sovetnikovmm/turn-signal-indicator/fabrication/turn-signal-indicator.step

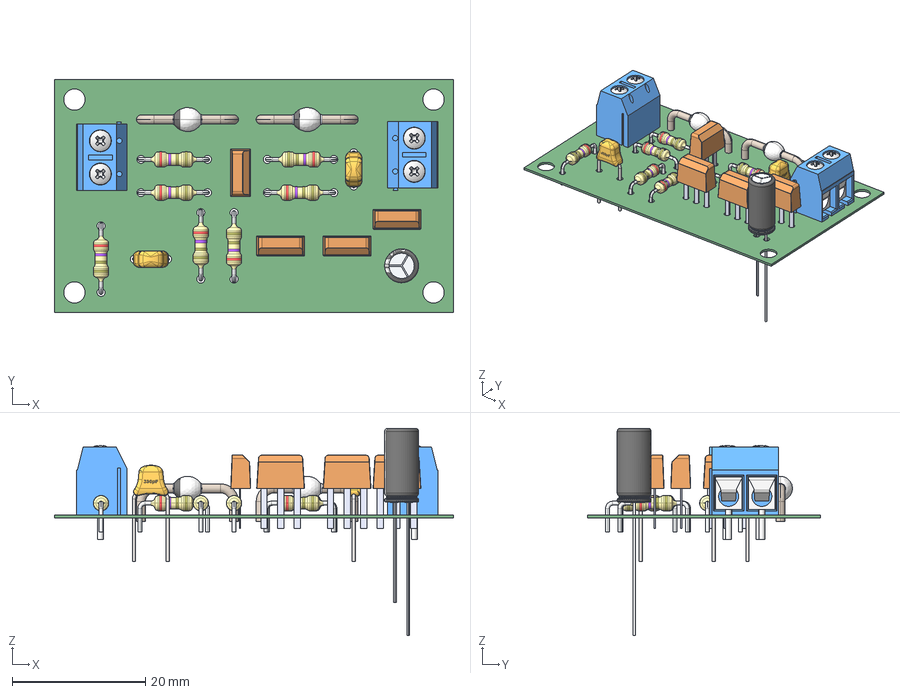
[picture p6: CAD file, 2026-11-12]
fabrication/turn-signal-indicator.step
60.0 x 35.0 x 31.2 mm
330pF MLCC Ceramic Capacitor x 4
Elco 10uF-35V (5 x 11 mm)
2.7R 0.4 x 7
User Library-KD29-C x 2
KT-13_1 x 4
case x 2
Terminal1 x 4
Screw1 x 4
