sovetnikovmm/turn-signal-indicator/docs/original-ru/turn-signal-indicator_E3_schematic.PDF

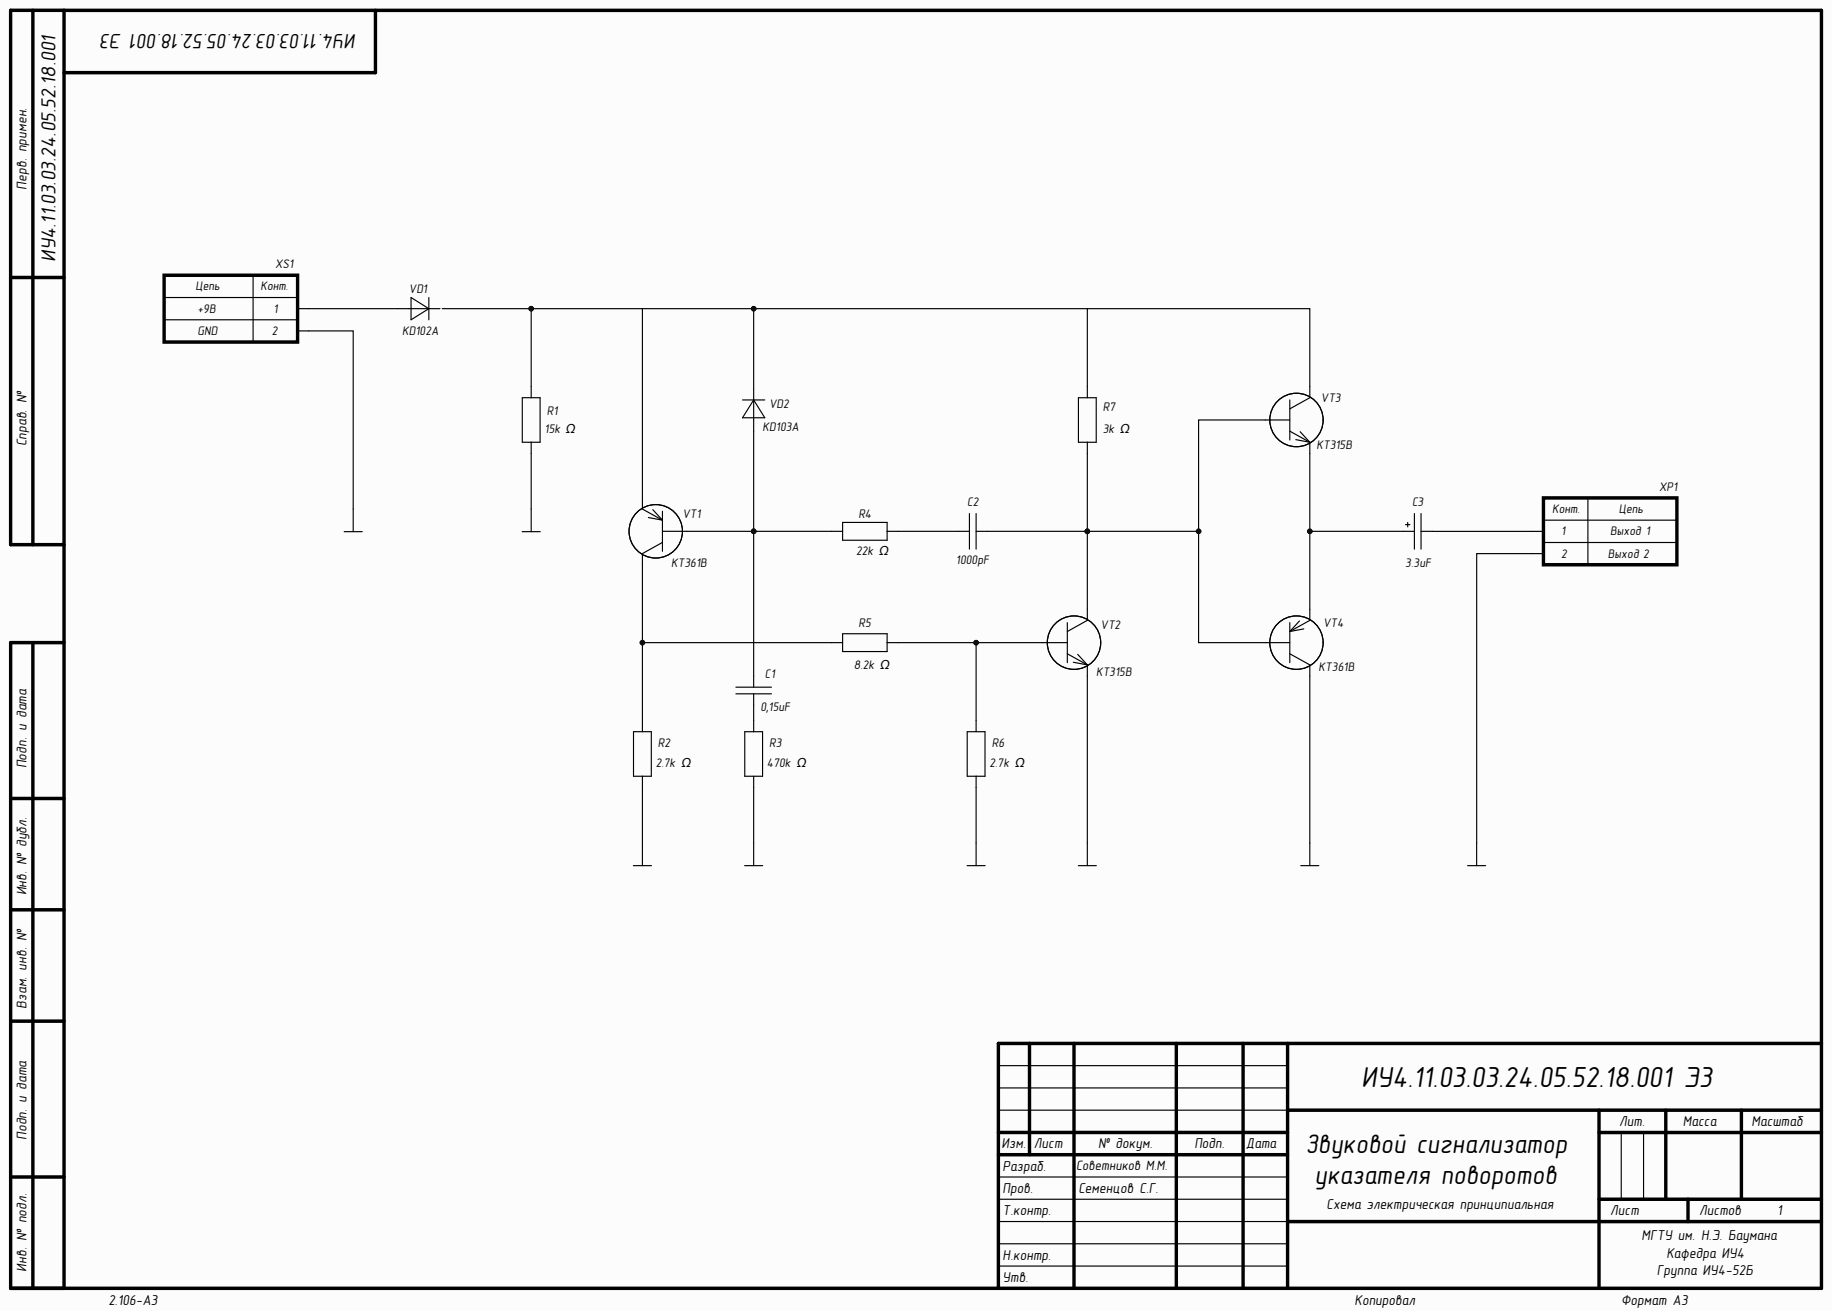
[picture p7: page 1]

Инв. № подл. Инв. № дубл. Подп. и дата Взам. инв. № Подп. и дата Перв. примен. Справ. №

Цеп ь | Конт .

GND

Конт . | Цеп ь

12 | Выход 1

Выход 2

Звуковой сигнализатор указателя поворотов Схема электрическая принципиальная | Лит . | Мас с а | Масштаб

Изм . | Лис т | № докум . | Подп . | Дата
Разраб . | | Советников М . М .
Пров . | | Семенцов С . Г .
Т .контр . | | | | | Лис т | Листов 1

МГТУ им. Н . Э. Баумана Кафедра ИУ 4 Группа ИУ4-52 Б

Н .контр .
Утв .
