sovetnikovmm/turn-signal-indicator/docs/original-ru/turn-signal-indicator_E1_block-diagram.PDF

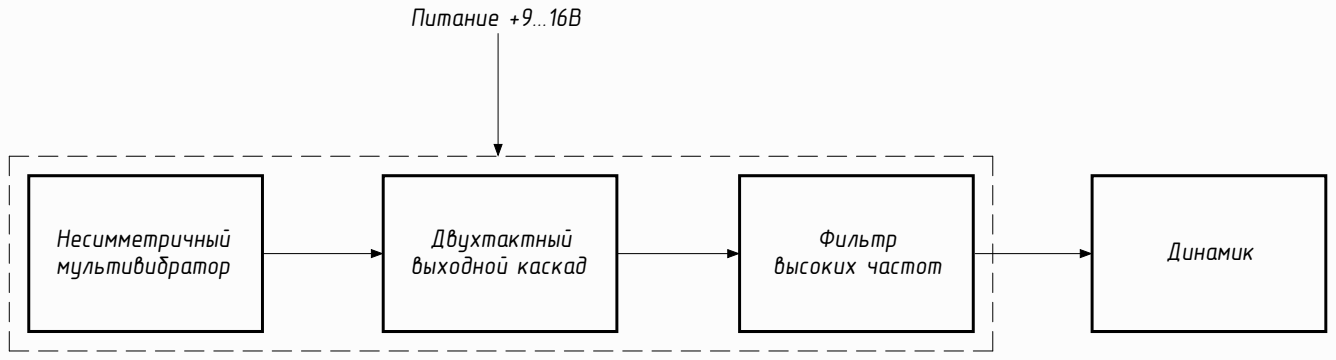
[picture p8: page 1]

Подп. и дата Перв. примен. Справ. №

Инв. № подл. Инв. № дубл. Подп. и дата Взам. инв. №

Звуковой сигнализатор указателя поворотов Схема электрическая структурная | Лит. | Масса | Масштаб

Изм. | Лист | № докум. | Подп. | Дата
Разраб. | | Советников М.М.
Пров. | | Семенцов С.Г.
Т.контр. | | | | | Лист | Листов 1

МГТУ им. Н.Э. Баумана Кафедра ИУ4 Группа ИУ4-52Б

Н.контр.
Утв.
