sovetnikovmm/turn-signal-indicator/docs/original-ru/turn-signal-indicator_PP_board-drawing.PDF

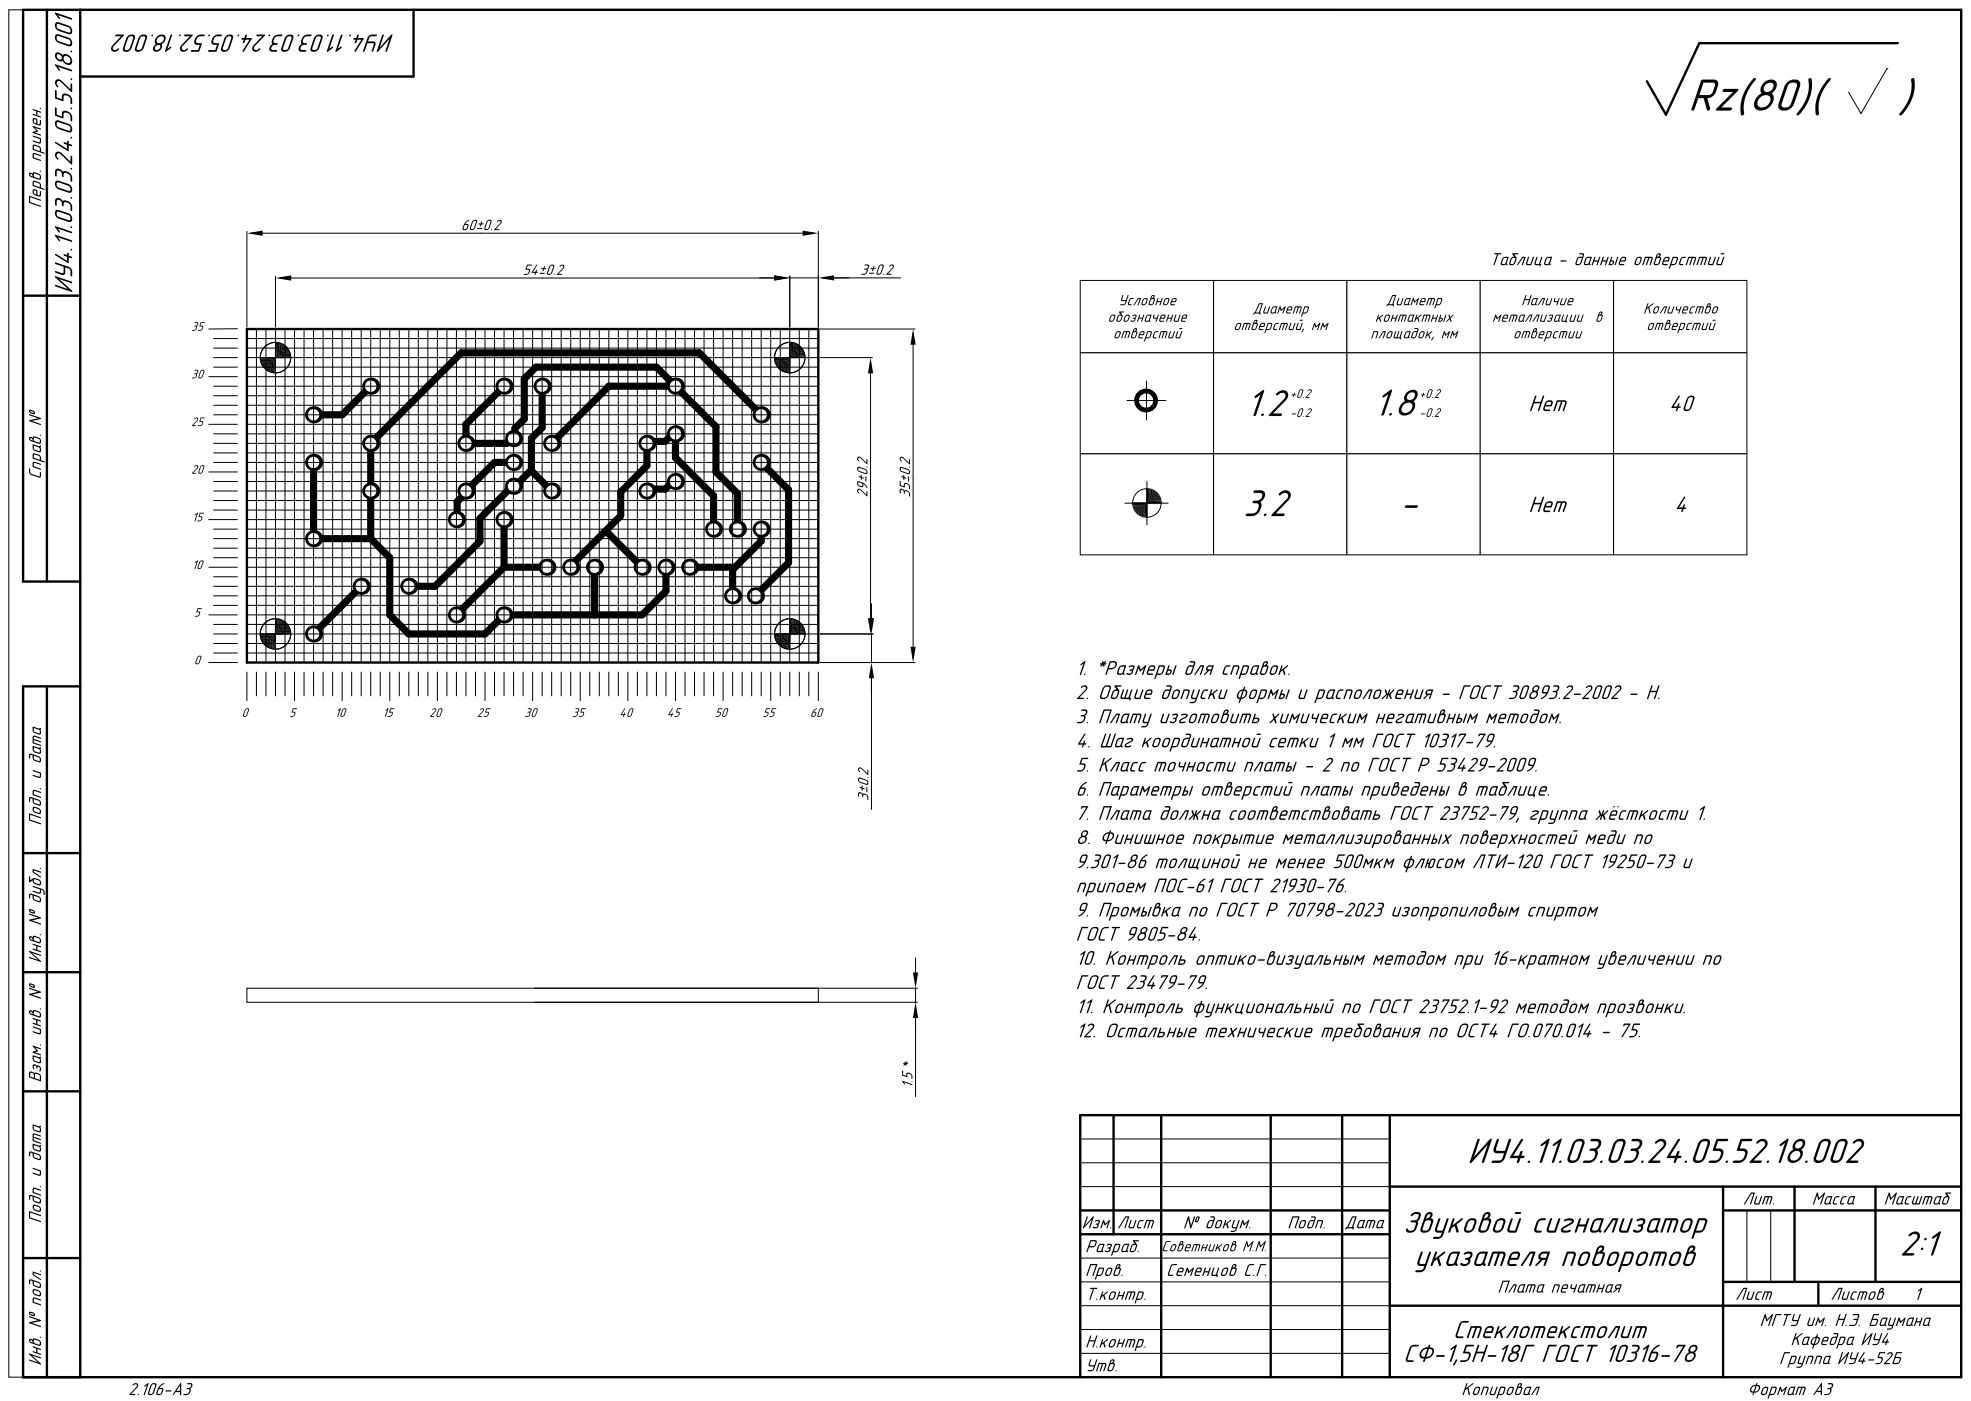
[picture p9: page 1]
