sovetnikovmm/turn-signal-indicator/(list of files, drawings)

Other design files:
hardware/altium/turn-signal-indicator.PcbDoc
hardware/altium/turn-signal-indicator.PrjPcb
hardware/altium/turn-signal-indicator_E1_block-diagram.SchDoc
hardware/altium/turn-signal-indicator_E3_schematic.SchDoc
