sovetnikovmm/turn-signal-indicator/(commit log)

2026-11-13 Update BOM files
2026-11-13 Update README BOM table
